AUROVA-LAB/aurova_clear/documentation/electronics/CLEAR_encoders.pdf

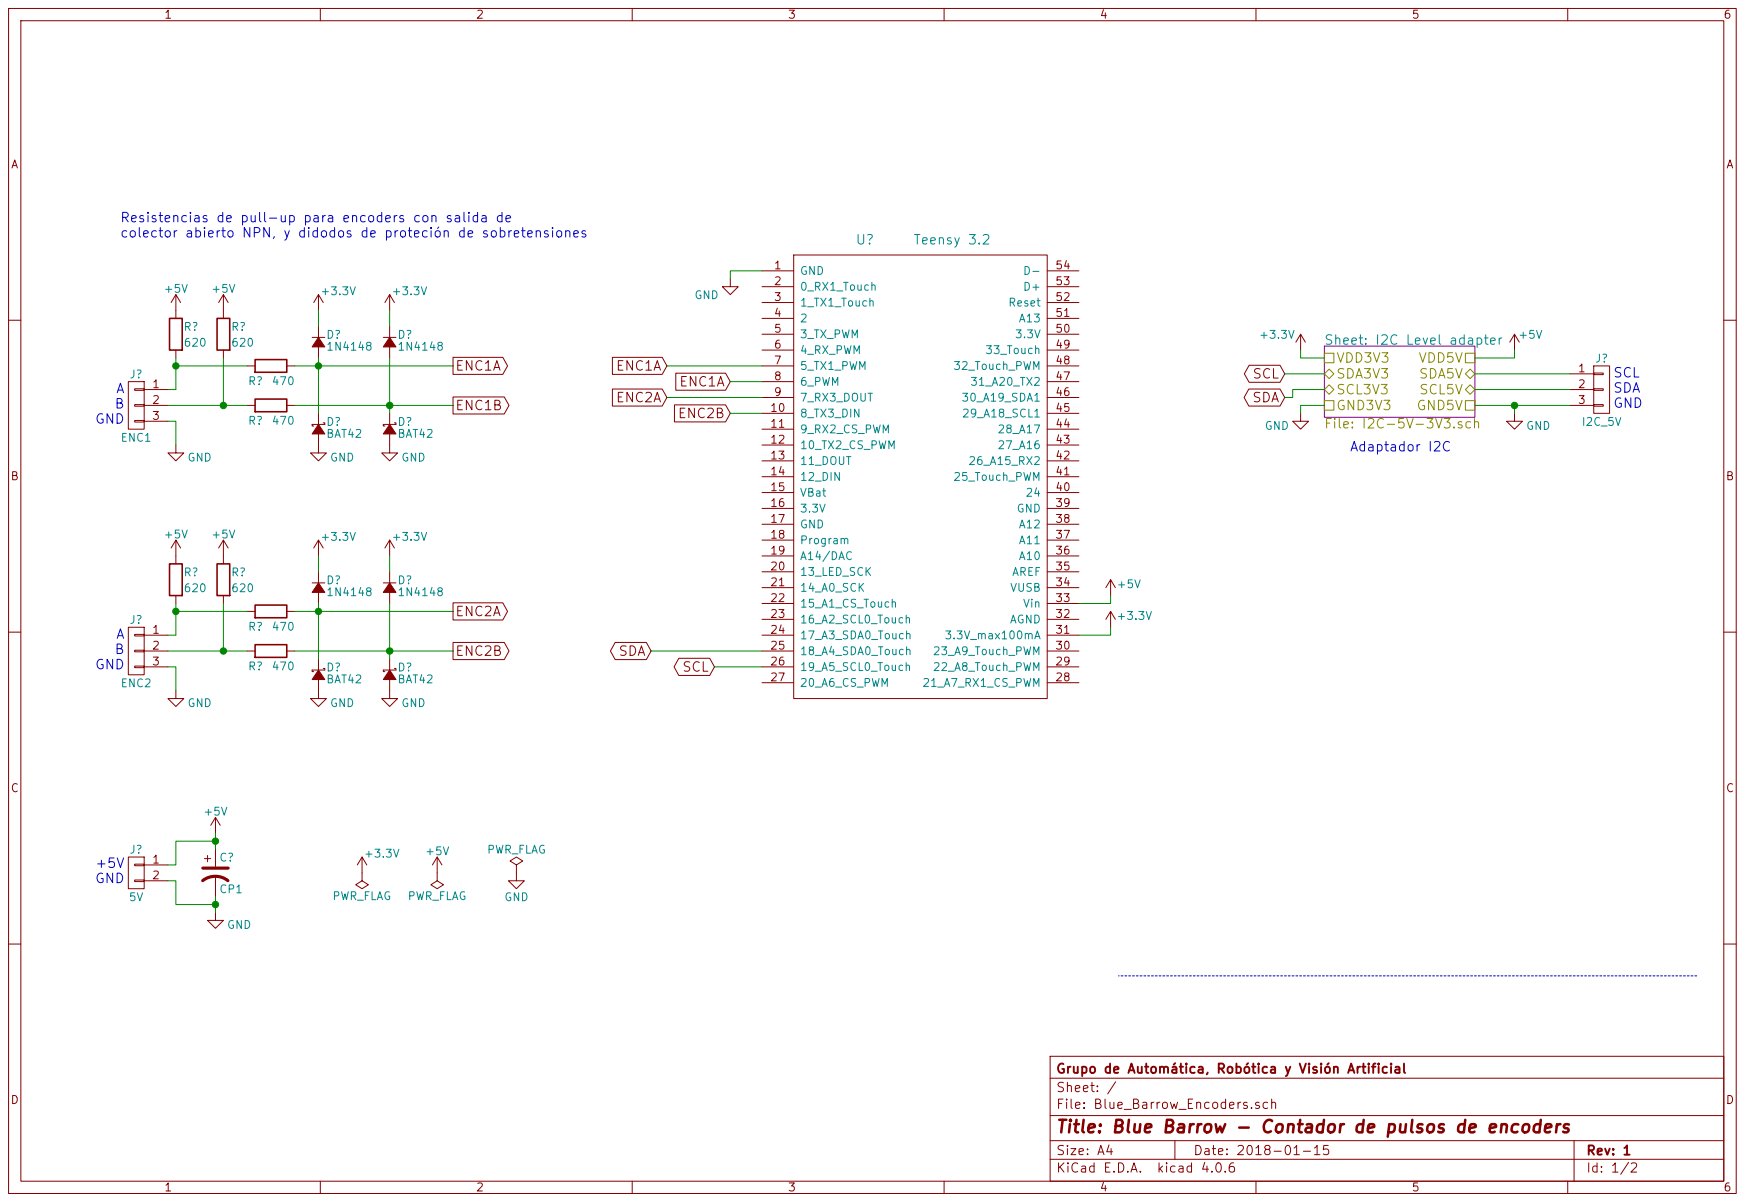
[picture p2: page 1]

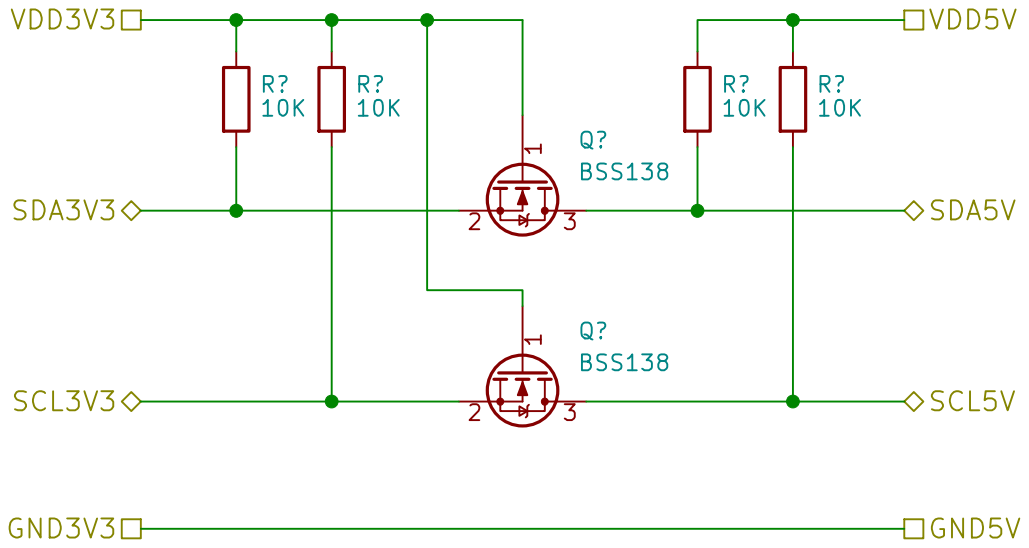
[picture p3: page 2]
