AUROVA-LAB/aurova_clear/documentation/electronics/CLEAR_Shield_mega.pdf

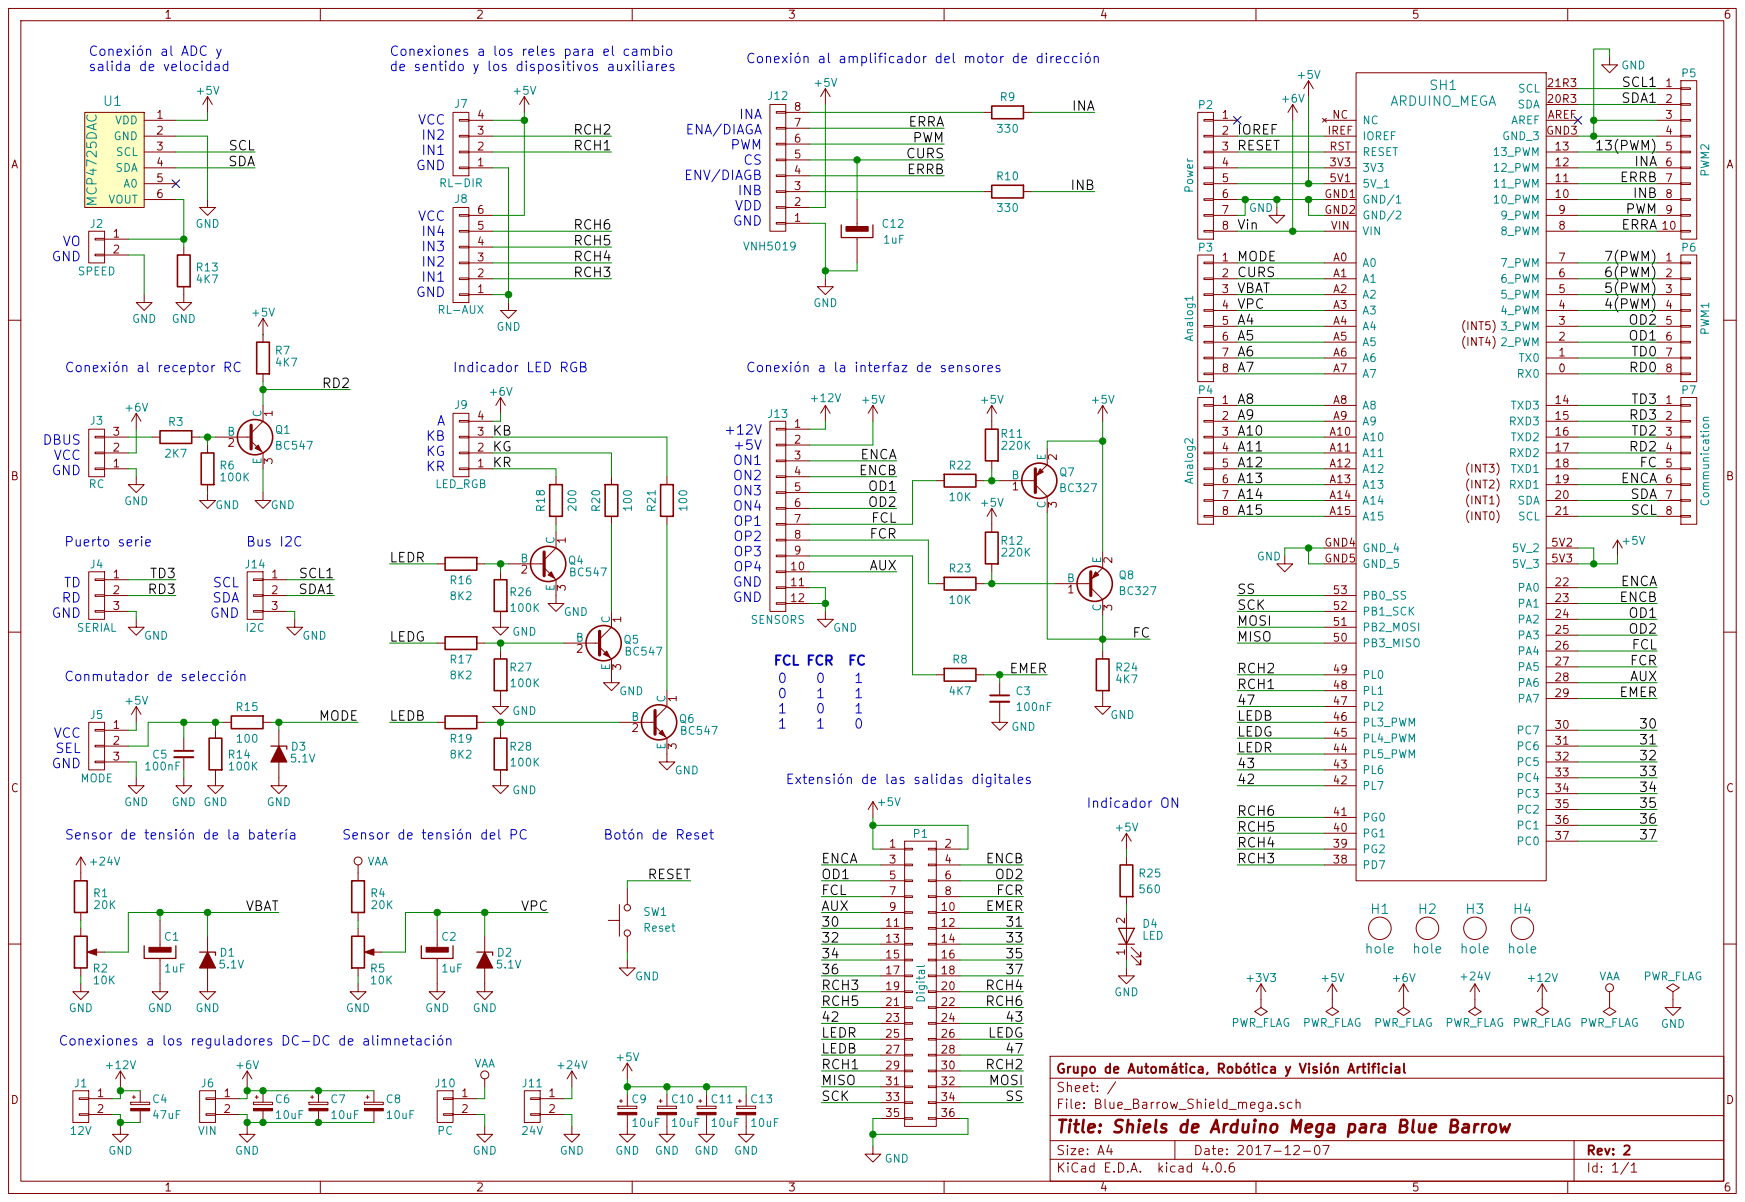
[picture p4: page 1]
